badrobotics/Raptor2000/(threads)

Thread 1 (2019-05-30):

USB OTG Support

dkitzman, 2019-05-30:
The current USB setup only hooks up the data lines. I believe that using OTG requires us to do more stuff, but could allow us to be more flexible in the future with master/slave behavior.

dkitzman, 2019-06-01:
4.3.3 USB OTG
TM4C129x devices that support USB OTG mode include the signals for USB Device mode, signals for
USB Host mode and an additional signal USB0ID located on pin PB0. This USB ID signal is the 5th pin
found on a USB micro-AB connector. If a micro-A cable end is plugged into this connector, the ID pin on
the cable is tied to ground causing the TM4C129x device to operate as a USB host. If a micro-B cable end
is plugged into the USB connector, the ID pin is left floating. In this case, the TM4C129x device's internal
pull-up on the USB0ID signal causes the controller to operate in device mode.
In order to limit damage from ESD events, a 100Ω resistor should be placed in series between the ID pin
on the USB connector and USB0ID(PB0) on the microcontroller.
To support full USB OTG negotiation using the SRP and HNP protocols, VBUS from the USB connector
must be directly connected to USB0VBUS(PB1) of the microcontroller without a series resistor in between.
In this case, USB0VBUS should be connected to an ESD suppressor such as a TVS diode, or ESD
resistant VBUS switch.

dkitzman, 2019-06-06:
Resolved in PR #9

Closed 2019-06-06.

Thread 2 (2019-06-01):

Real-time Clock Support

dkitzman, 2019-06-01:
We'd like to be able to use the RTC peripheral. I think all this will take is a battery, but I'm not sure.

dkitzman, 2019-06-05:
http://www.ti.com/lit/an/spma056/spma056.pdf

TI has info about this on page 23. Looks like I need a couple passive components, and also a 32kHz oscillator to run the hibernation module. Not sure if powering the hibernation module is required for the RTC, or if it's just the other way around? Either way, I likely want a config resistor that lets me short VBatt to VDD in the case we don't install a battery.

Closed 2019-06-29.

Thread 3 (2019-06-01):

External EPI RAM

dkitzman, 2019-06-01:
We need more memory than the TM4C129 can give us. We can go up to 64KB, and I think we should.

dkitzman, 2019-06-01:
The schematic for this is ready for peer review.

dkitzman, 2019-06-29:
Resolved by #12

Closed 2019-06-29.

Thread 4 (2019-06-01):

MicroSD Reader

dkitzman, 2019-06-01:
We need some NVM on this thing to store application binaries and various file system stuff. I think the easiest form for this to take is a microsd card.

dkitzman, 2019-06-01:
This circuit is ready for peer review.

dkitzman, 2019-06-19:
Remember to pull up the CS

dkitzman, 2019-06-22:
Decided to remove in favor of NAND Flash.
See issue #11

Closed 2019-06-22.

Thread 5 (2019-06-01):

Main Connector Pinout

dkitzman, 2019-06-01:
My current plan is to use a Samtec ET60T as the primary connector on this card. Which configuration of this we go with is up to more discussion.

Signals this board needs:
- Ethernet * 4
- USB * 4
- Board Sense
- JTAG * 5
- Enable
- Inhibit
- Sysreset

That's 17 of our 24 pins. Comment on this issue if you think of anything else.

dkitzman, 2019-06-29:
Resolved by #12

Closed 2019-06-29.

Thread 7 (2019-06-01):

TM4C129x Supporting Circuitry

dkitzman, 2019-06-01:
This is our main cpu on this board, and it requires some supporting components to function properly. Read the datasheet!

dkitzman, 2019-06-29:
Resolved by #12

Closed 2019-06-29.

Thread 8 (2019-06-01):

Misc LEDs and Status Indicators

dkitzman, 2019-06-01:
The current design doesn't have any LEDs apart from a power LED. We want Ethernet leds, and probably some generic, cpu controlled ones as well.

dkitzman, 2019-06-29:
Resolved by #12

Closed 2019-06-29.
