badrobotics/Raptor2000/doc/sch/Raptor2000.pdf

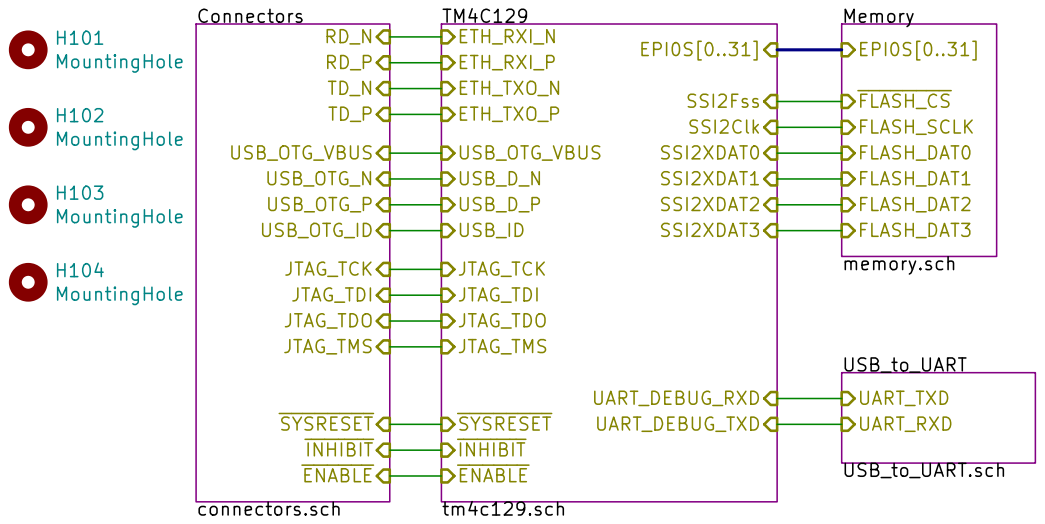
[picture p1: page 1]

File: Raptor2000.sch Sheet: / BAD Robotics

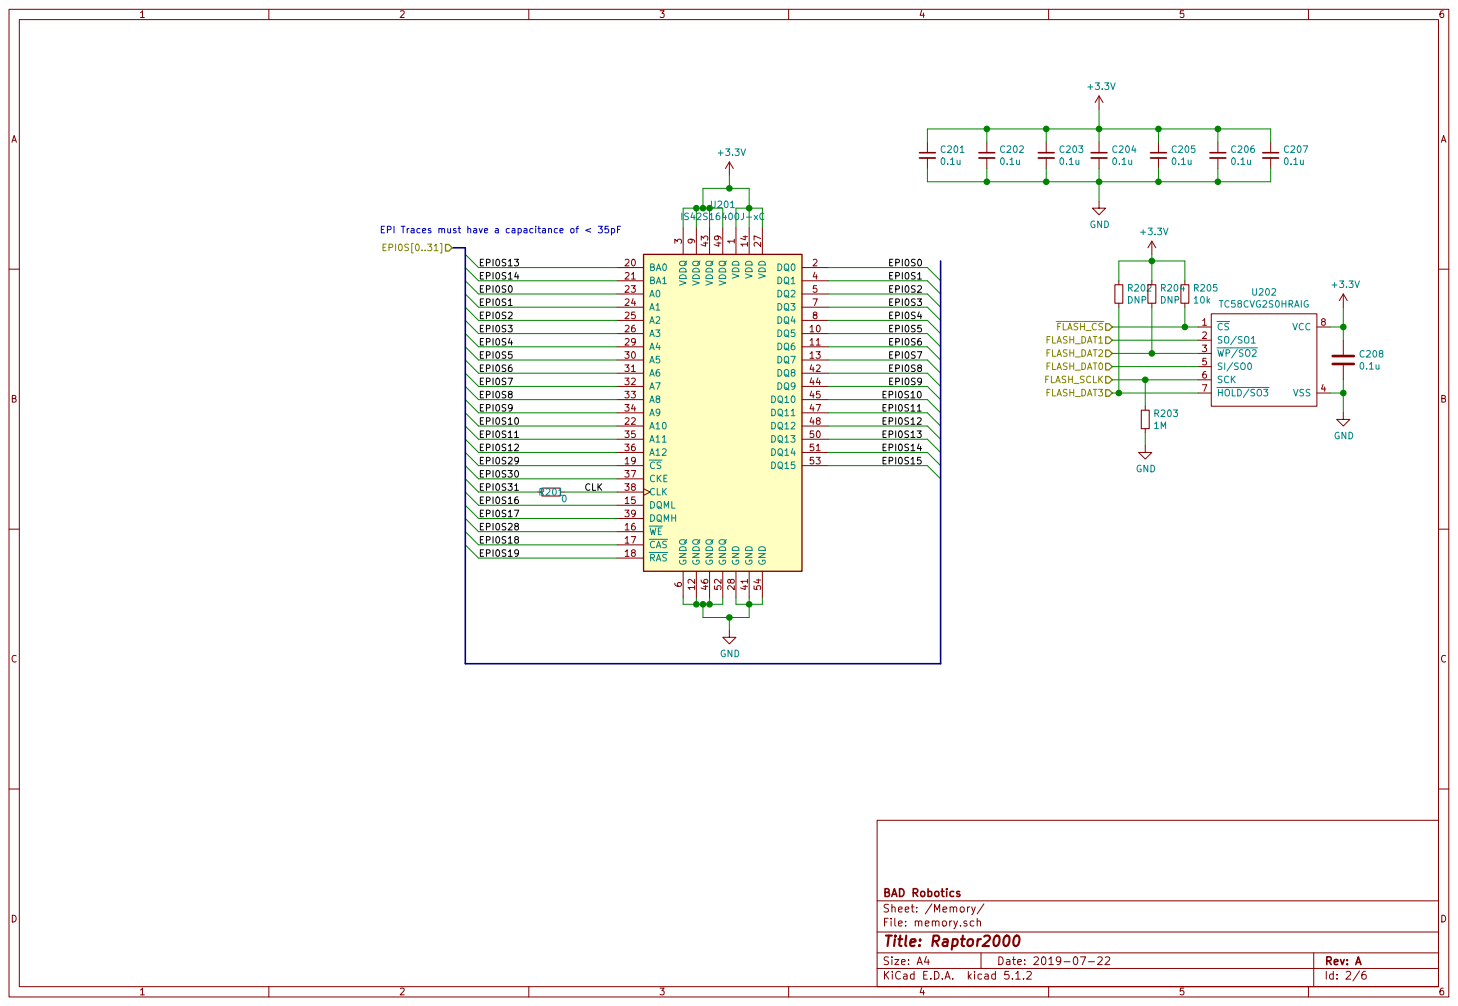
[picture p2: page 2]

EPI Traces must have a capacitance of < 35pF

1 DQ5 10 DQ6 11 GNDQ 12 DQ7 13 VDD 14 DQML 15 WE 16 CAS 17 RAS 18 CS 19 DQ0 2 BA0 20 BA1 21 A10 22 A0 23 A1 24 A2 25 A3 26 VDD 27 GND 28 A4 29 VDDQ

3 A5 30 A6 31 A7 32 A8 33 A9 34 A11 35 A12 36 CKE 37 CLK 38 DQMH 39 DQ1 4 GND 41 DQ8 42 VDDQ 43 DQ9 44 DQ10 45 GNDQ 46 DQ11 47 DQ12 48 VDDQ 49 DQ2 5 DQ13 50 DQ14 51 GNDQ 52 DQ15 53 GND 54 GNDQ

Sheet: /Memory/ BAD Robotics R201

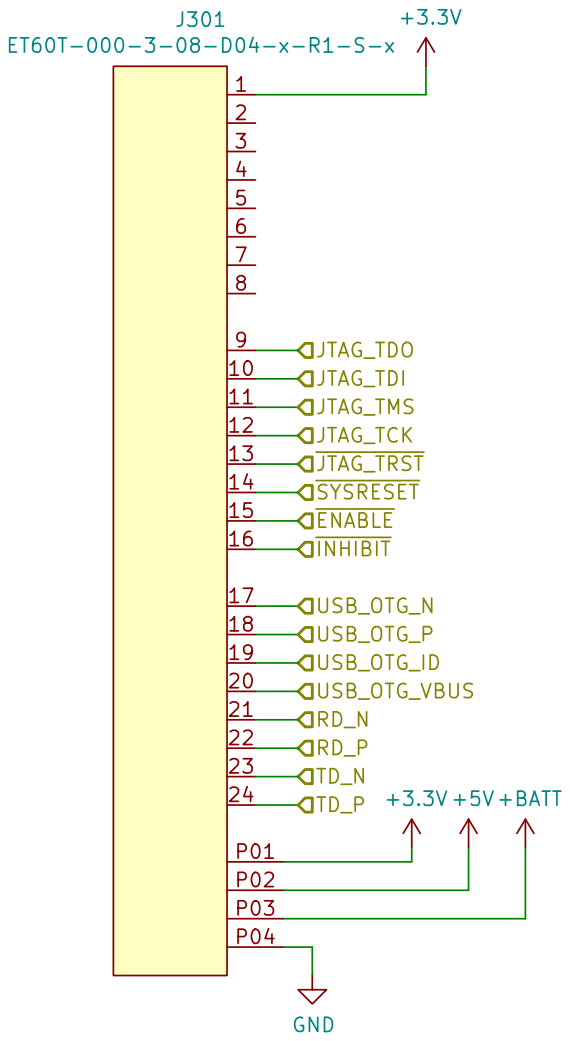
[picture p3: page 3]

USB_OTG_VBUS USB_OTG_N
USB_OTG_P
File: connectors.sch Sheet: /Connectors/ BAD Robotics USB_OTG_ID

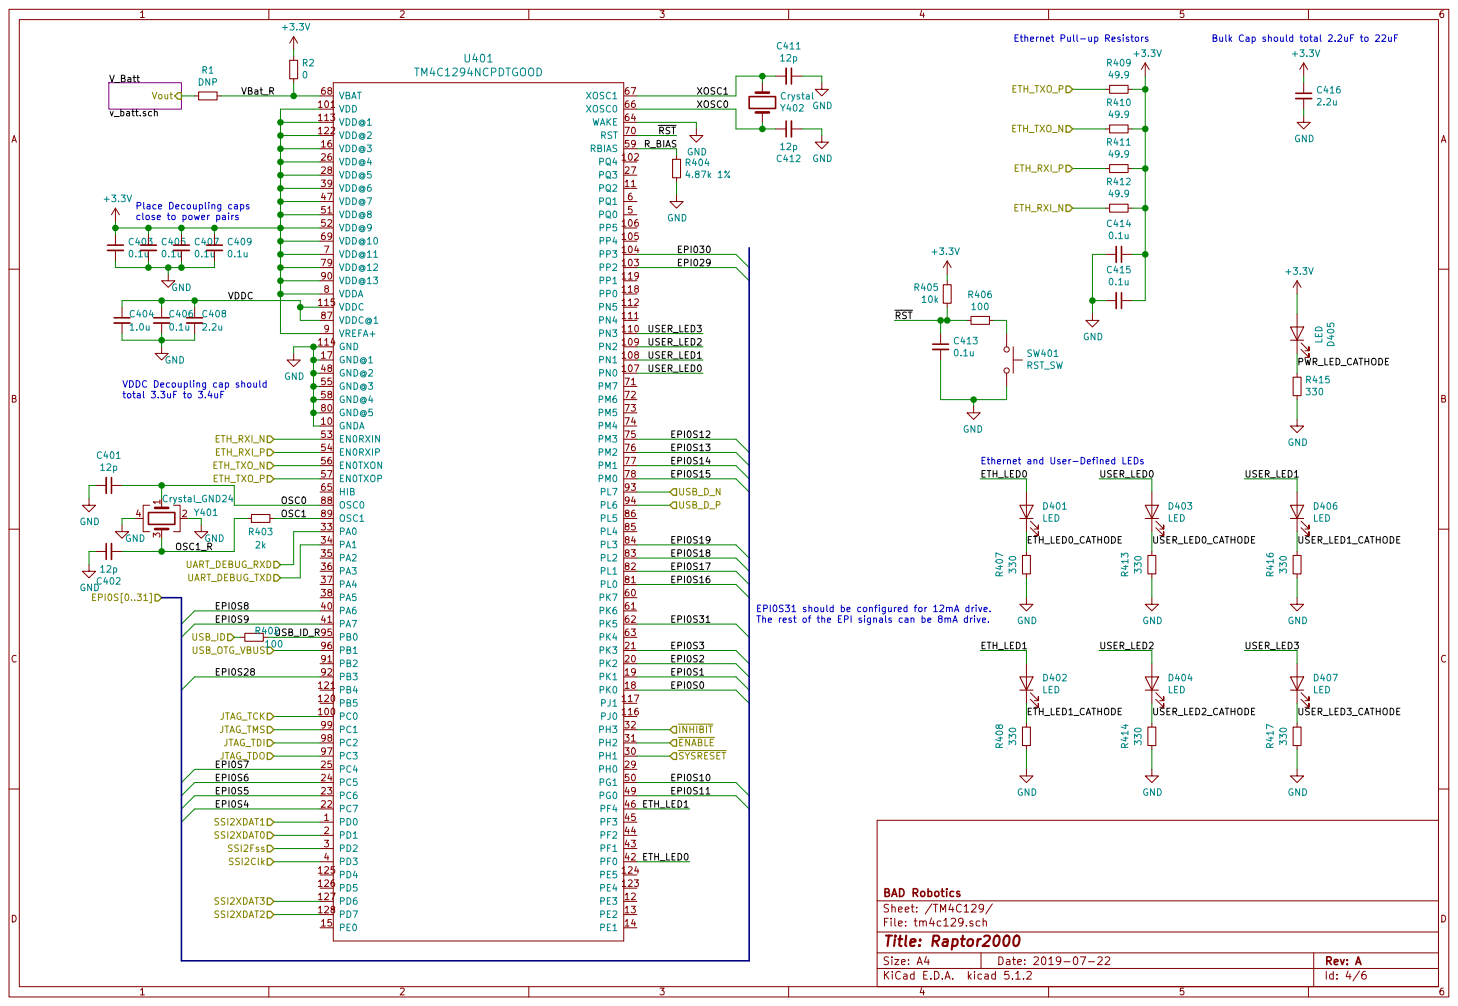
[picture p4: page 4]

File: tm4c129.sch Sheet: /TM4C129/ BAD Robotics OSC0 OSC1 C404

VDDC Decoupling cap should

The rest of the EPI signals can be 8mA drive.

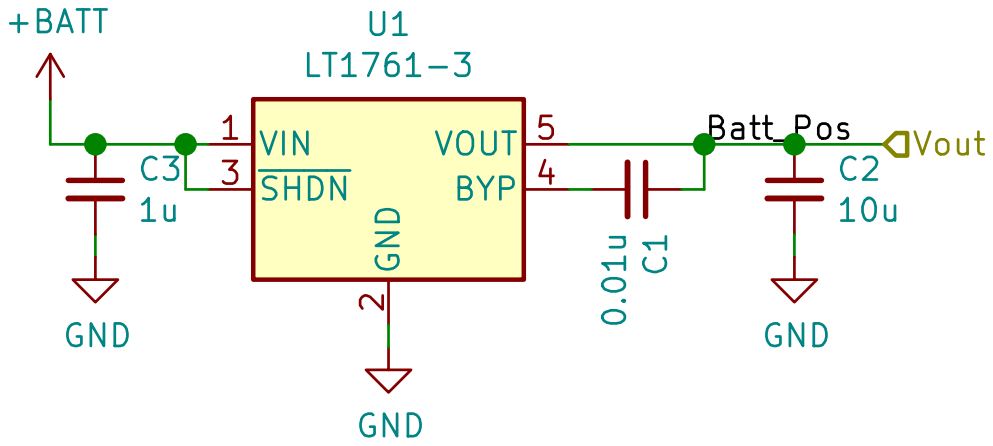
[picture p5: page 5]

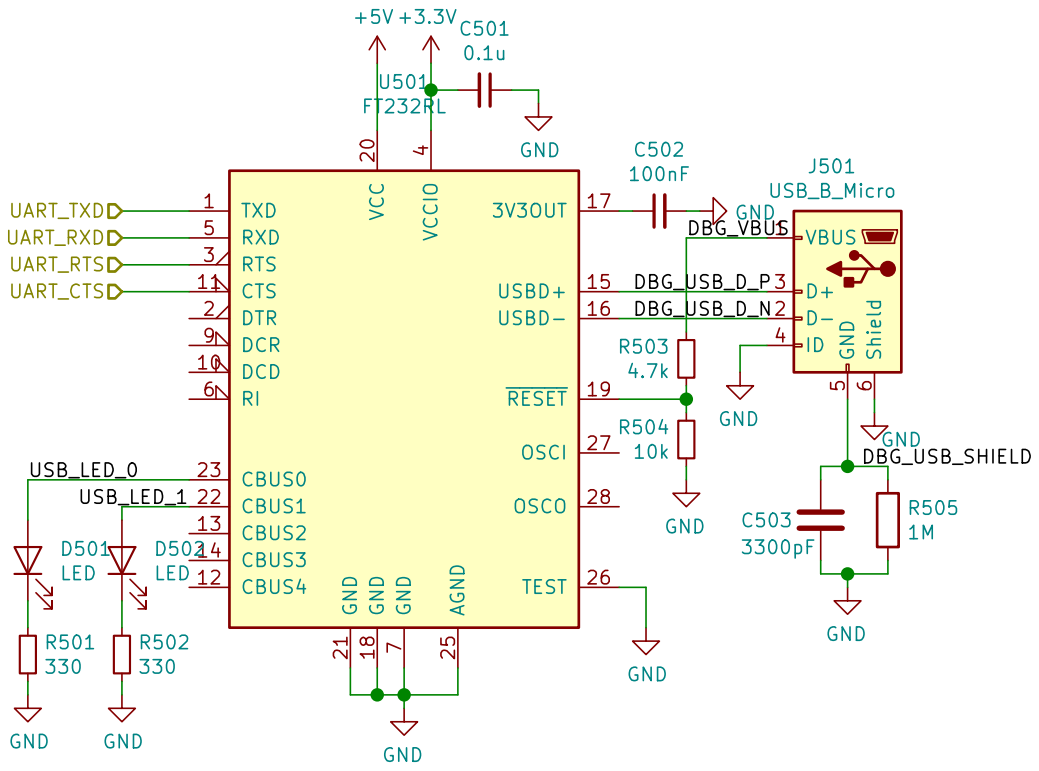
[picture p6: page 6]
