badrobotics/Raptor2000/doc/pcb/Raptor2000-B_Cu.pdf

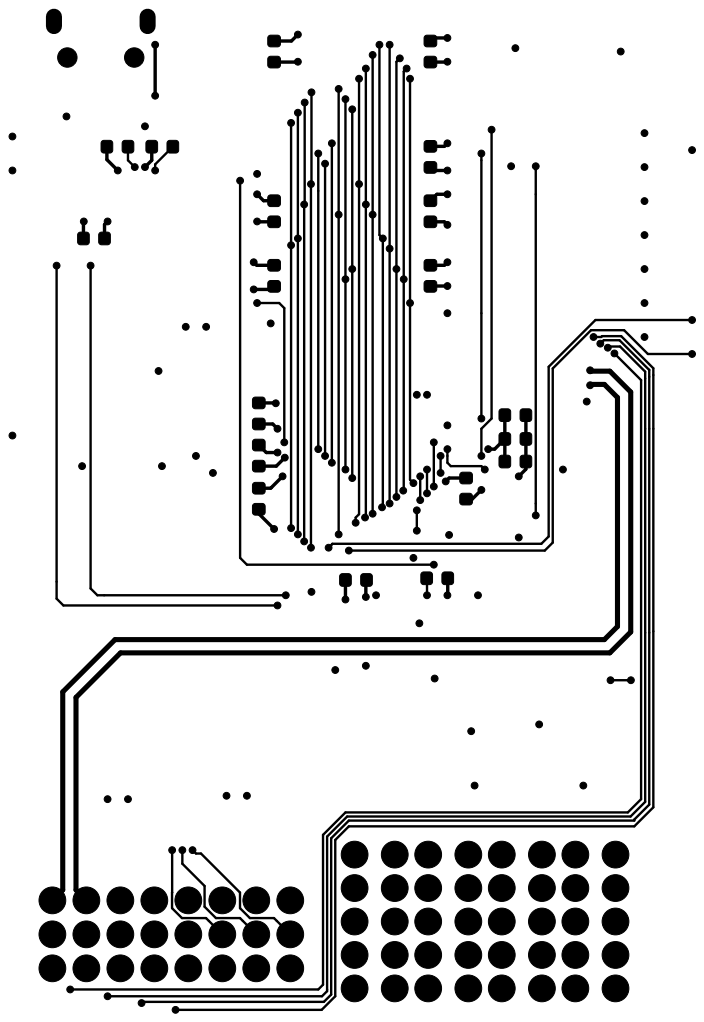
[picture p7: page 1]
