badrobotics/Raptor2000/doc/pcb/Raptor2000-B_Mask.pdf

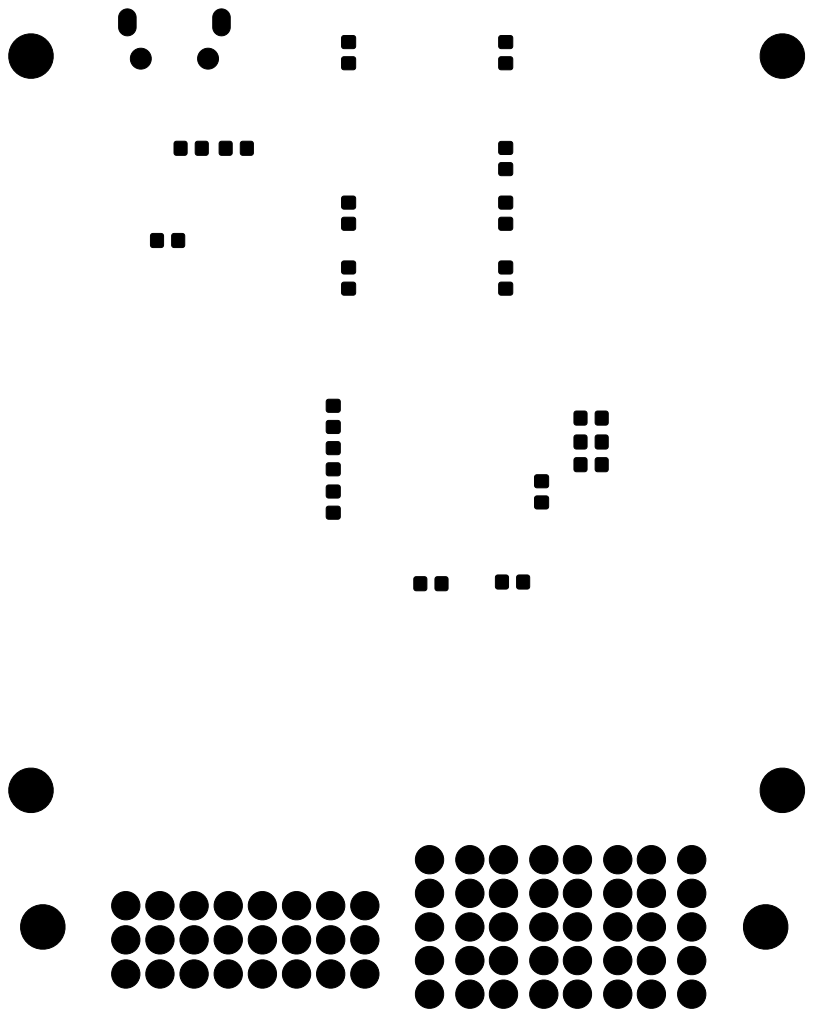
[picture p8: page 1]
