badrobotics/Raptor2000/doc/pcb/Raptor2000-B_Paste.pdf

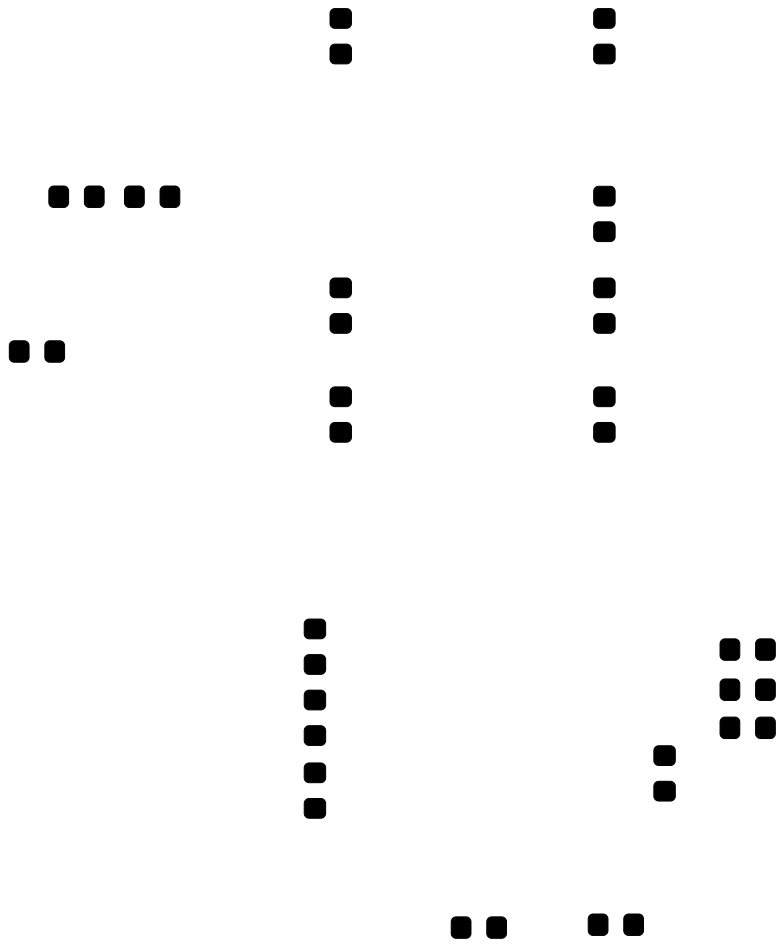
[picture p9: page 1]
