badrobotics/Raptor2000/doc/pcb/Raptor2000-B_SilkS.pdf

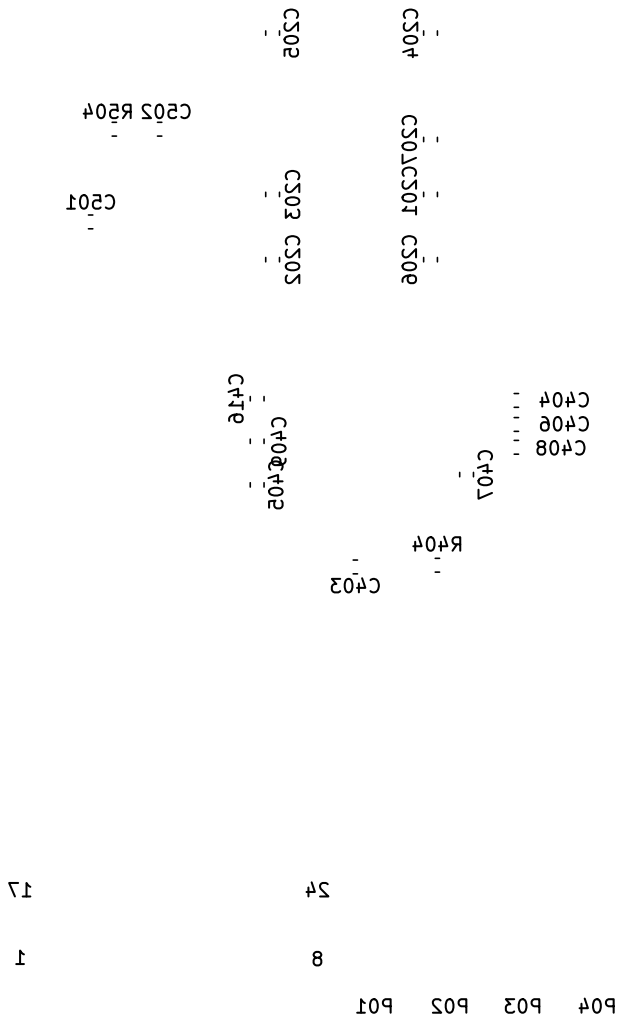
[picture p10: page 1]
