badrobotics/Raptor2000/doc/pcb/Raptor2000-F_Cu.pdf

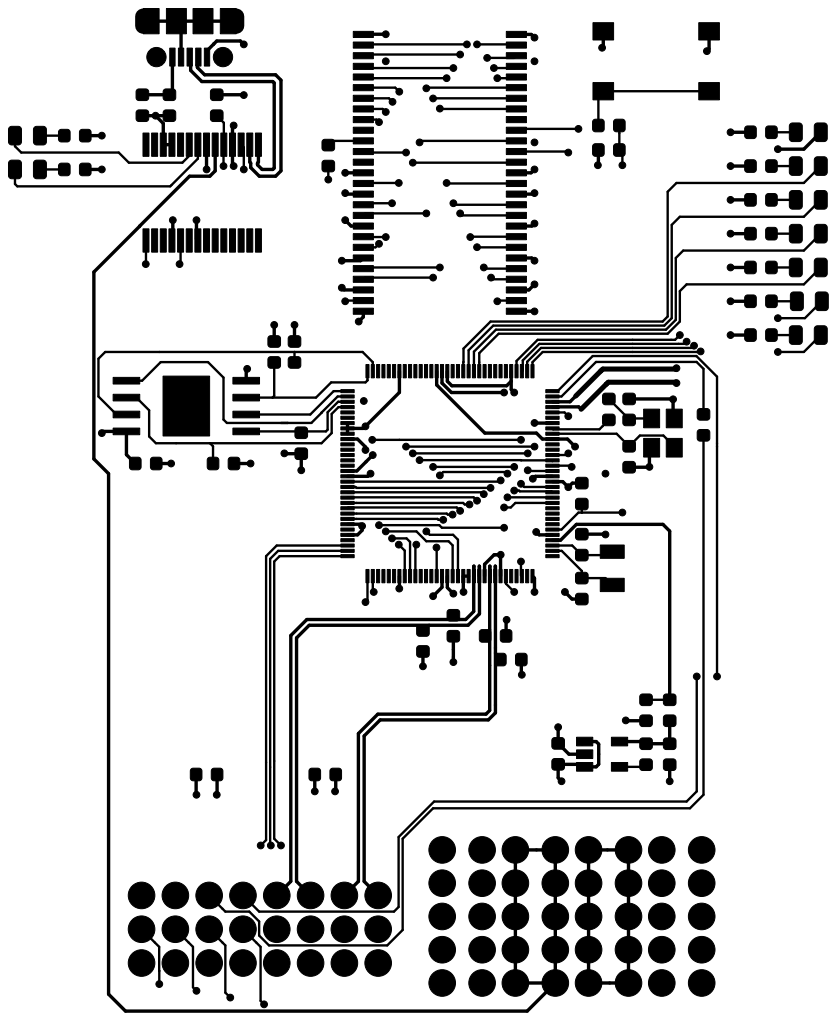
[picture p11: page 1]
