badrobotics/Raptor2000/doc/pcb/Raptor2000-F_Mask.pdf

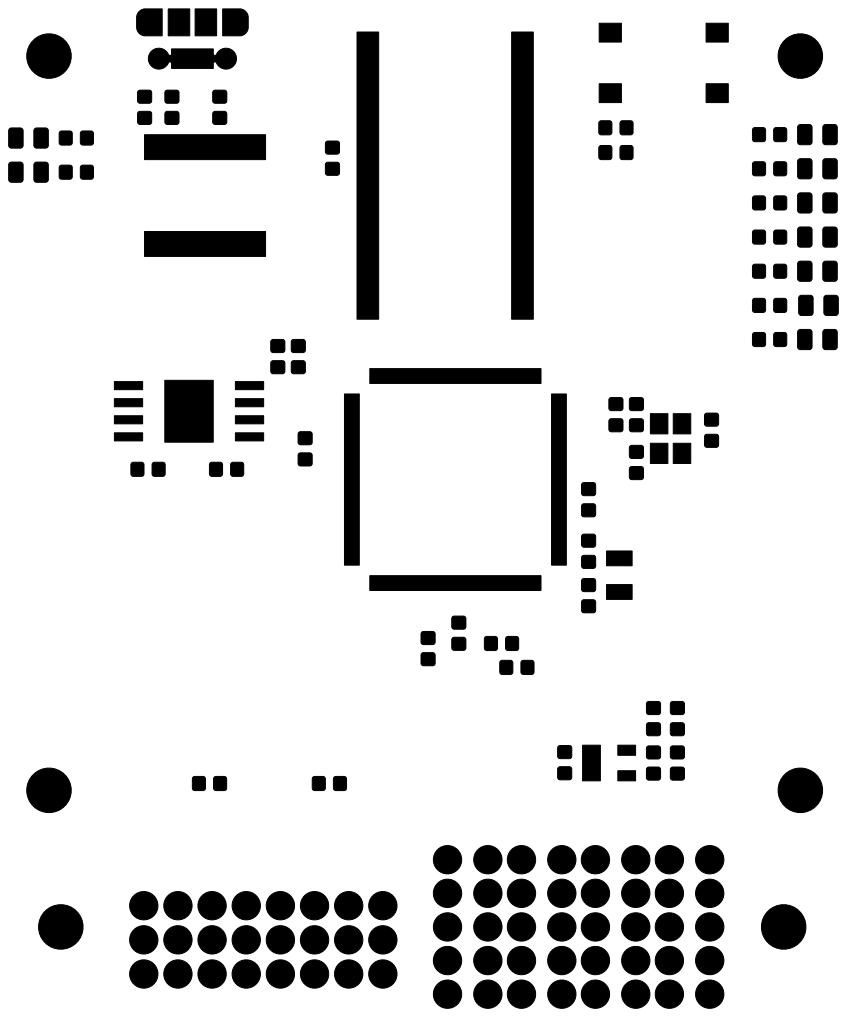
[picture p12: page 1]
