badrobotics/Raptor2000/doc/pcb/Raptor2000-F_Paste.pdf

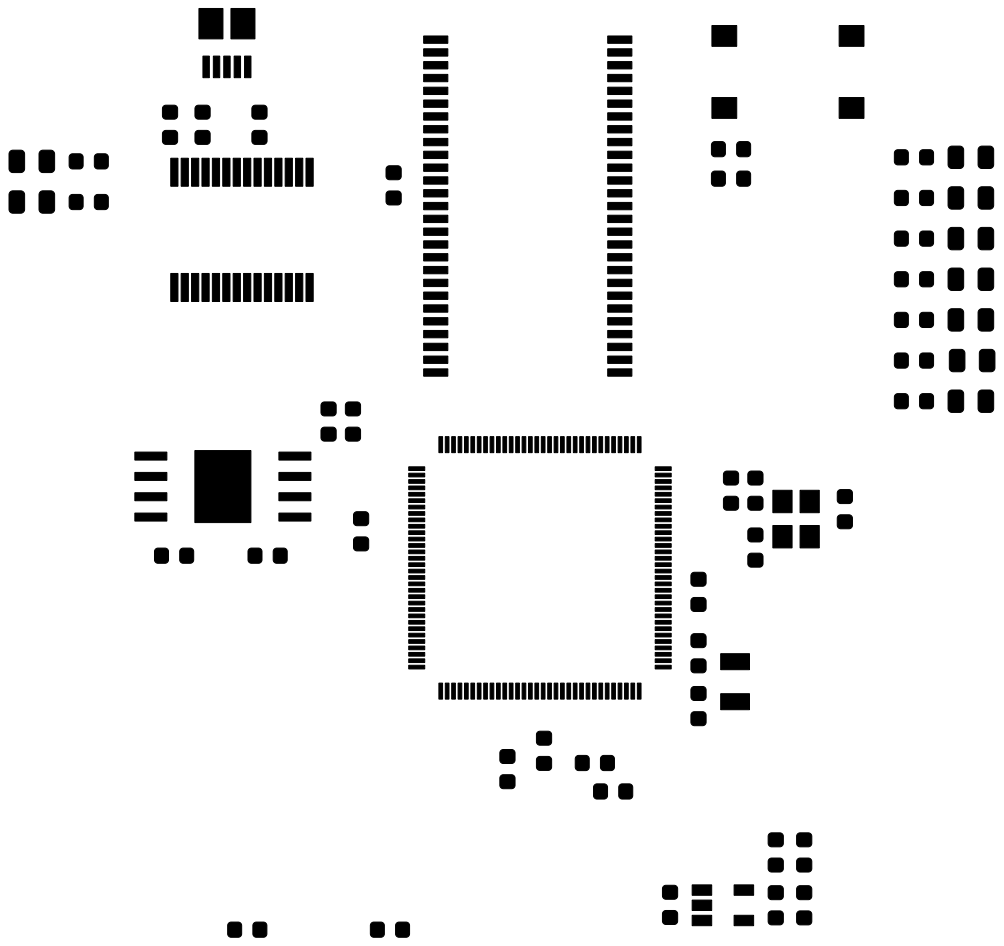
[picture p13: page 1]
