badrobotics/Raptor2000/doc/pcb/Raptor2000-F_SilkS.pdf

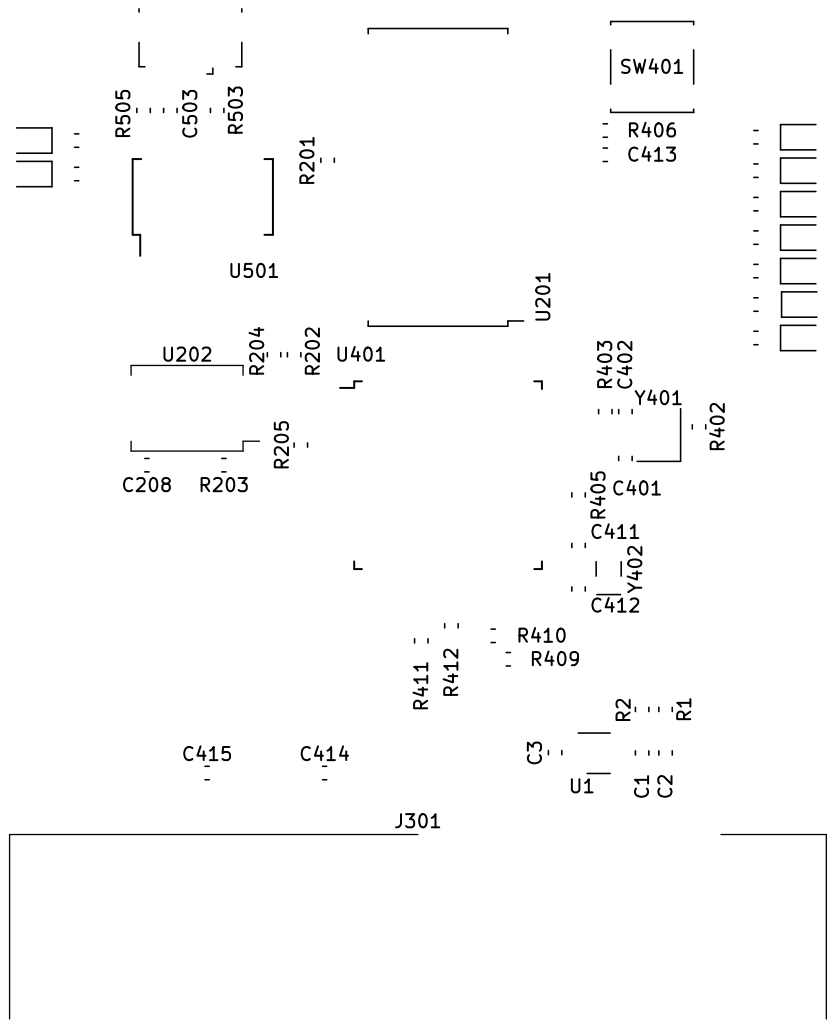
[picture p14: page 1]
