badrobotics/Raptor2000/doc/pcb/Raptor2000-In1_Cu.pdf

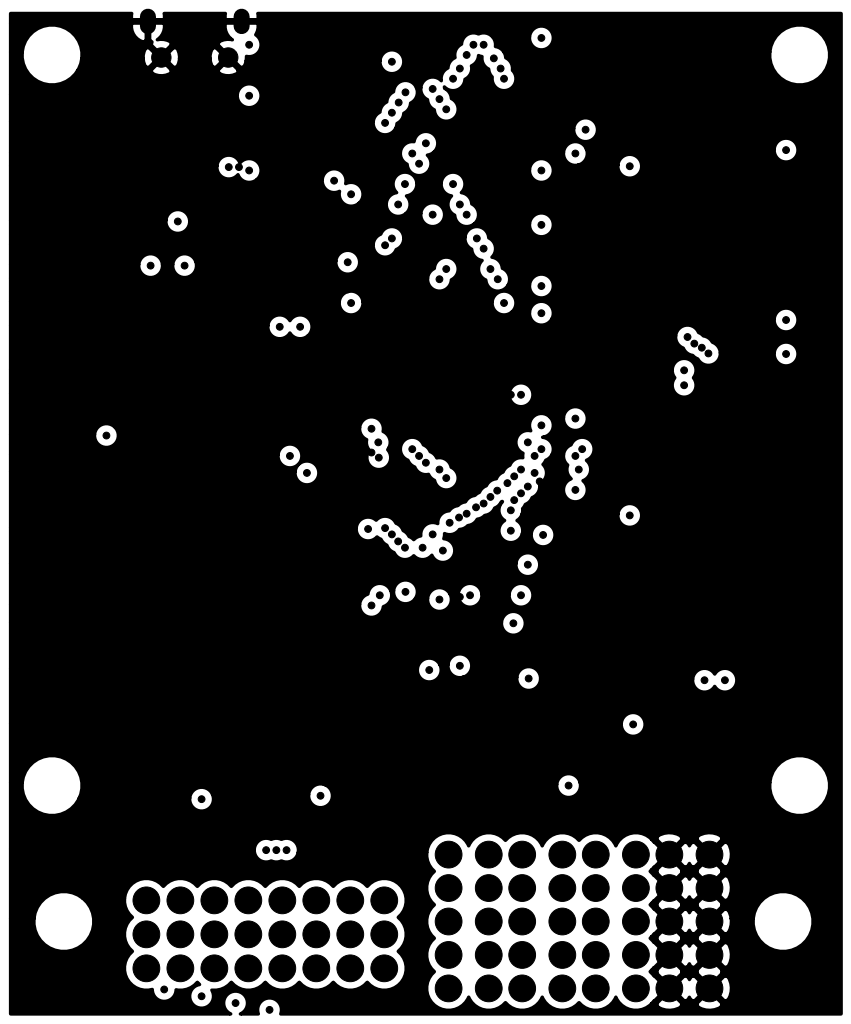
[picture p15: page 1]
