badrobotics/Raptor2000/doc/pcb/Raptor2000-In2_Cu.pdf

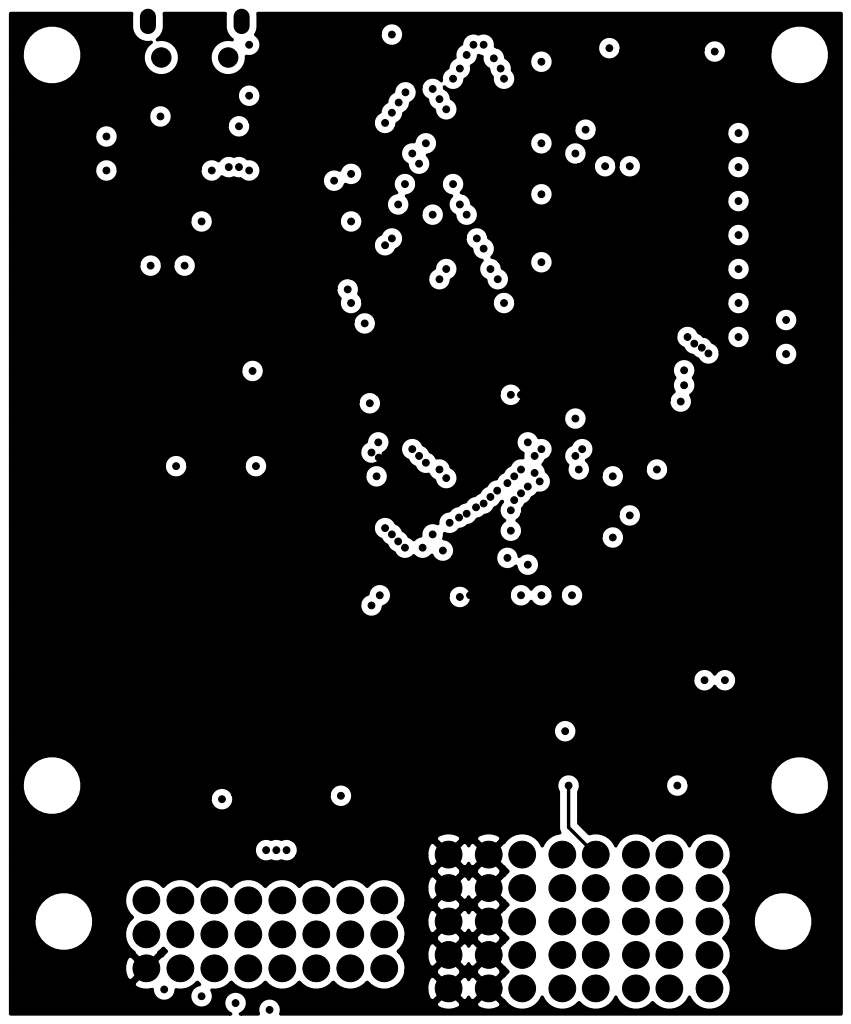
[picture p16: page 1]
