badrobotics/Raptor2000/doc/vbatt_lt1761.asc

C1: cap; 1µ
C2: cap; 0.01µ
C3: cap; 10µ
C4: cap; 1µ
R1: res; 51
U1: LT1761-3
V1: voltage; 12
Named nets: 0
.tran .05 startup
