badrobotics/Raptor2000/Raptor2000.kicad_pcb

## KiCad design Raptor2000.kicad_pcb (2019-07-23)

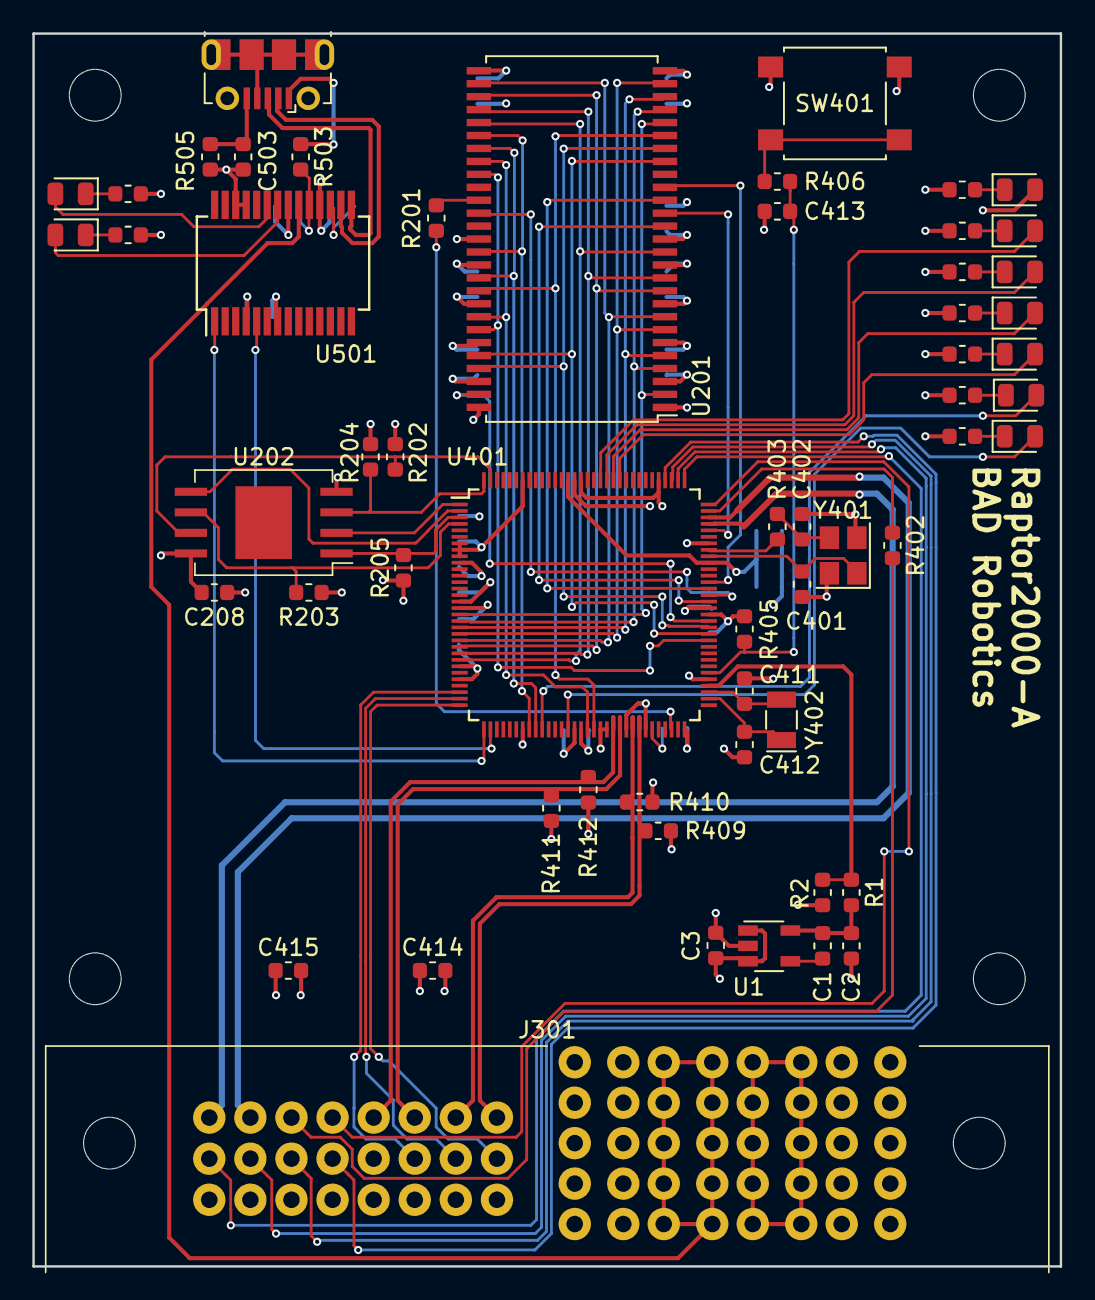
[picture p17: board Raptor2000.kicad_pcb from above]

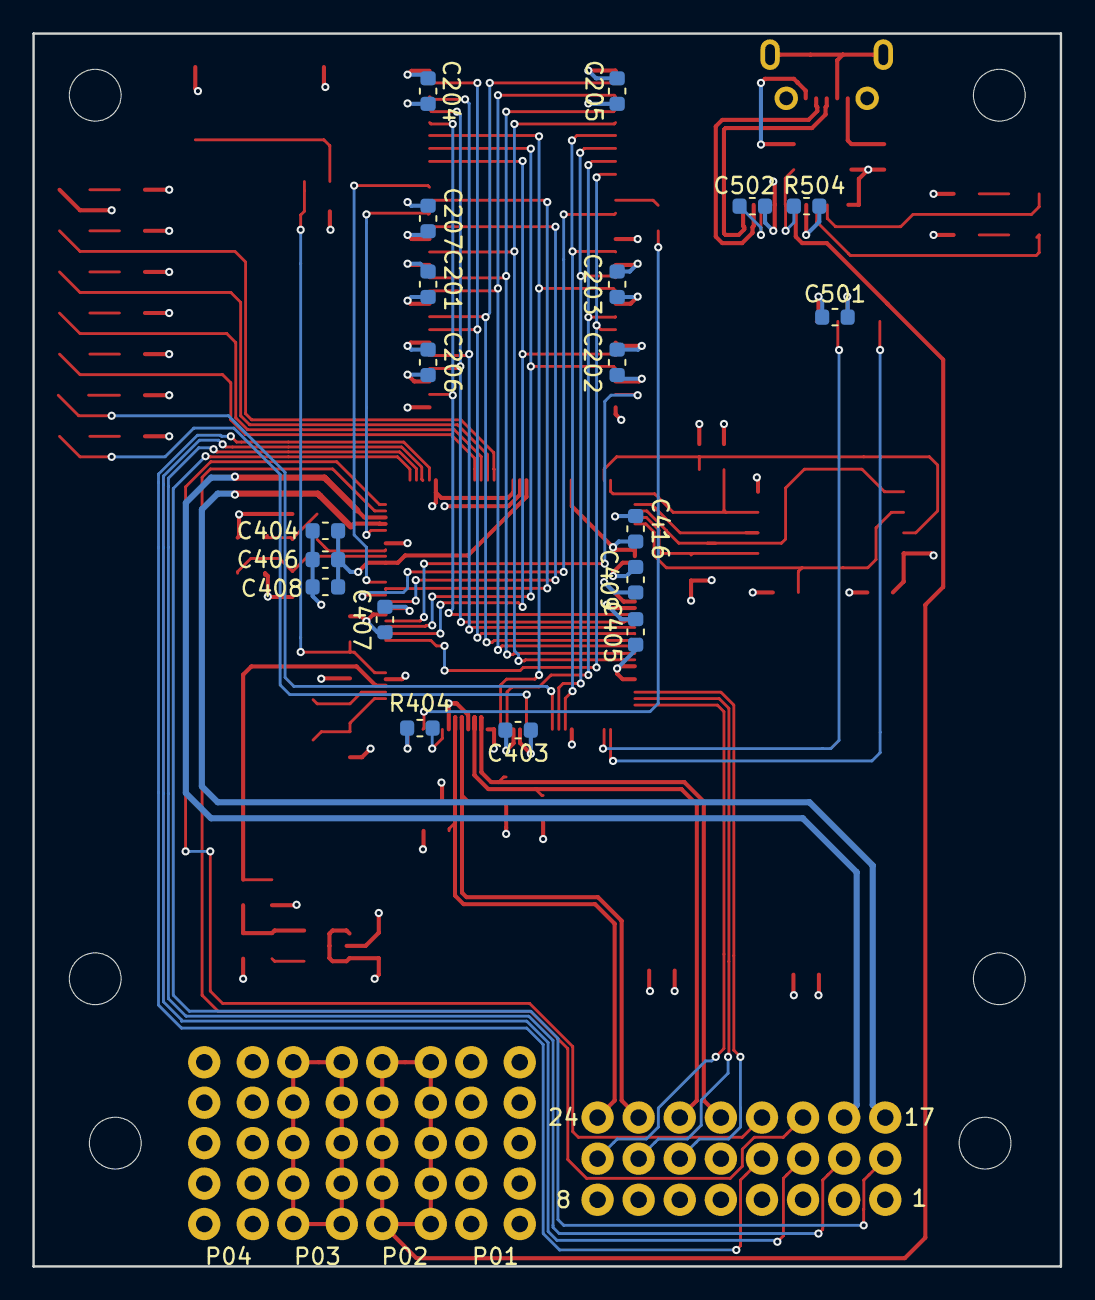
[picture p18: board Raptor2000.kicad_pcb from below]

Board: 4 copper layers, 63.5 x 76.2 mm, 80 parts (19 on the bottom side), 86 nets.

Parts:
C1: 0.01u; C_0603_1608Metric
C2: 10u; C_0603_1608Metric
C3: 1u; C_0603_1608Metric
C201, C202, C203, C204, C205, C206, C207, C208, C403, C405, C406, C407, C409, C413, C414, C415, C501: 0.1u; C_0603_1608Metric
C401, C402, C411, C412: 12p; C_0603_1608Metric
C404: 1.0u; C_0603_1608Metric
C408, C416: 2.2u; C_0603_1608Metric
C502: 100nF; C_0603_1608Metric
C503: 3300pF; C_0603_1608Metric
D401, D402, D403, D404, D405, D406, D407, D501, D502: LED; LED_0805_2012Metric
H101, H102, H103, H104: MountingHole; MountingHole_3.2mm_M3
J301: ET60T-000-3-08-D04-x-R1-S-x; Conn_Samtec_ET60T-000-3-08-D-4-x-R1-S-x
J501: USB_B_Micro; USB_Micro-B_Molex-105017-0001
R1, R202, R204: DNP; R_0603_1608Metric
R2, R201: 0; R_0603_1608Metric
R203, R505: 1M; R_0603_1608Metric
R205, R405, R504: 10k; R_0603_1608Metric
R402, R406: 100; R_0603_1608Metric
R403: 2k; R_0603_1608Metric
R404: 4.87k 1%; R_0603_1608Metric
R407, R408, R413, R414, R415, R416, R417, R501, R502: 330; R_0603_1608Metric
R409, R410, R411, R412: 49.9; R_0603_1608Metric
R503: 4.7k; R_0603_1608Metric
SW401: RST_SW; SW_SPST_B3S-1000
U1: LT1761-3; TSOT-23-5
U201: IS42S16400J-xC; TSOP-II-54_22.2x10.16mm_P0.8mm
U202: TC58CVG2S0HRAIG; WSON-8-1EP_3.4x4.3mm_P1.27mm
U401: TM4C1294NCPDTGOOD; TQFP-128_14x14mm_P0.4mm
U501: FT232RL; SSOP-28_5.3x10.2mm_P0.65mm
Y401: Crystal_GND24; Crystal_SMD_3225-4Pin_3.2x2.5mm
Y402: Crystal; Crystal_SMD_MicroCrystal_CC7V-T1A-2Pin_3.2x1.5mm

Connections:
+3V3: C201.1, C202.1, C203.1, C204.1, C205.1, C206.1, C207.1, C208.1, C403.1, C405.1, C407.1, C409.1, C414.1, C415.1, C416.1, C501.2, D405.2, J301.1, J301.P01, R2.2, R202.1, R204.1, R205.1, R405.2, R409.1, R410.1, R411.1, R412.1, U201.1, U201.3, U201.9, U201.14, U201.27, U201.43, U201.49, U202.8, U401.7, U401.8, U401.9, U401.16, U401.26, U401.28, U401.39, U401.47, U401.51, U401.52, U401.69, U401.79, U401.90, U401.101, U401.113, U401.122, U501.4
+5V: J301.P02, U501.20
+BATT: C3.1, J301.P03, U1.1, U1.3
/Connectors/JTAG_TCK: J301.12, U401.100
/Connectors/JTAG_TDI: J301.10, U401.98
/Connectors/JTAG_TDO: J301.9, U401.97
/Connectors/JTAG_TMS: J301.11, U401.99
/Connectors/USB_OTG_VBUS: J301.20, U401.96
/Connectors/~ENABLE: J301.15, U401.31
/Connectors/~INHIBIT: J301.16, U401.32
/Connectors/~SYSRESET: J301.14, U401.30
/Memory/CLK: R201.1, U201.38
/Memory/EPI0S0: U201.2, U201.23, U401.18
/Memory/EPI0S1: U201.4, U201.24, U401.19
/Memory/EPI0S2: U201.5, U201.25, U401.20
/Memory/EPI0S3: U201.7, U201.26, U401.21
/Memory/EPI0S4: U201.8, U201.29, U401.22
/Memory/EPI0S5: U201.10, U201.30, U401.23
/Memory/EPI0S6: U201.11, U201.31, U401.24
/Memory/EPI0S7: U201.13, U201.32, U401.25
/Memory/EPI0S8: U201.33, U201.42, U401.40
/Memory/EPI0S9: U201.34, U201.44, U401.41
/Memory/EPI0S10: U201.22, U201.45, U401.50
/Memory/EPI0S11: U201.35, U201.47, U401.49
/Memory/EPI0S12: U201.36, U201.48, U401.75
/Memory/EPI0S13: U201.20, U201.50, U401.76
/Memory/EPI0S14: U201.21, U201.51, U401.77
/Memory/EPI0S15: U201.53, U401.78
/Memory/EPI0S16: U201.15, U401.81
/Memory/EPI0S17: U201.39, U401.82
/Memory/EPI0S18: U201.17, U401.83
/Memory/EPI0S19: U201.18, U401.84
/Memory/EPI0S28: U201.16, U401.92
/Memory/EPI0S31: R201.2, U401.62
/Memory/FLASH_DAT0: U202.5, U401.2
/Memory/FLASH_DAT1: U202.2, U401.1
/Memory/FLASH_DAT2: R204.2, U202.3, U401.128
/Memory/FLASH_DAT3: R202.2, U202.7, U401.127
/Memory/FLASH_SCLK: R203.1, U202.6, U401.4
/TM4C129/ETH_LED0: D401.2, U401.42
/TM4C129/ETH_LED0_CATHODE: D401.1, R407.2
/TM4C129/ETH_LED1: D402.2, U401.46
/TM4C129/ETH_LED1_CATHODE: D402.1, R408.2
/TM4C129/ETH_RXI_N: J301.21, R412.2, U401.53
/TM4C129/ETH_RXI_P: J301.22, R411.2, U401.54
/TM4C129/ETH_TXO_N: J301.23, R410.2, U401.56
/TM4C129/ETH_TXO_P: J301.24, R409.2, U401.57
/TM4C129/OSC0: C401.1, U401.88, Y401.1
/TM4C129/OSC1: R403.1, U401.89
/TM4C129/OSC1_R: C402.2, R403.2, Y401.3
/TM4C129/PWR_LED_CATHODE: D405.1, R415.2
/TM4C129/R_BIAS: R404.1, U401.59
/TM4C129/SSI2Fss: R205.2, U202.1, U401.3
/TM4C129/UART_DEBUG_RXD: U401.33, U501.1
/TM4C129/UART_DEBUG_TXD: U401.34, U501.5
/TM4C129/USB_D_N: J301.17, U401.93
/TM4C129/USB_D_P: J301.18, U401.94
/TM4C129/USB_ID: J301.19, R402.2
/TM4C129/USB_ID_R: R402.1, U401.95
/TM4C129/USER_LED0: D403.2, U401.107
/TM4C129/USER_LED0_CATHODE: D403.1, R413.2
/TM4C129/USER_LED1: D406.2, U401.108
/TM4C129/USER_LED1_CATHODE: D406.1, R416.2
/TM4C129/USER_LED2: D404.2, U401.109
/TM4C129/USER_LED2_CATHODE: D404.1, R414.2
/TM4C129/USER_LED3: D407.2, U401.110
/TM4C129/USER_LED3_CATHODE: D407.1, R417.2
/TM4C129/VBat_R: R1.1, R2.1, U401.68
/TM4C129/VDDC: C404.1, C406.1, C408.1, U401.87, U401.115
/TM4C129/V_Batt/Vout: C1.1, C2.1, R1.2, U1.5
/TM4C129/XOSC0: C412.1, U401.66, Y402.1
/TM4C129/XOSC1: C411.2, U401.67, Y402.2
/TM4C129/~RST: C413.1, R405.1, R406.1, U401.70
/USB_to_UART/DBG_USB_D_N: J501.2, U501.16
/USB_to_UART/DBG_USB_D_P: J501.3, U501.15
/USB_to_UART/DBG_USB_SHIELD: C503.1, J501.5, R505.1
/USB_to_UART/DBG_VBUS: J501.1, R503.1
/USB_to_UART/USB_LED_0: D501.2, U501.23
/USB_to_UART/USB_LED_1: D502.2, U501.22
GND: C2.2, C3.2, C201.2, C202.2, C203.2, C204.2, C205.2, C206.2, C207.2, C208.2, C401.2, C402.1, C403.2, C404.2, C405.2, C406.2, C407.2, C408.2, C409.2, C411.1, C412.2, C413.2, C414.2, C415.2, C416.2, C501.1, C502.2, C503.2, J301.P04, J501.4, J501.6, R203.2, R404.2, R407.1, R408.1, R413.1, R414.1, R415.1, R416.1, R417.1, R501.2, R502.2, R504.2, R505.2, SW401.1, U1.2, U201.6, U201.12, U201.28, U201.41, U201.46, U201.52, U201.54, U202.4, U401.10, U401.17, U401.48, U401.55, U401.58, U401.64, U401.80, U401.114, U501.7, U501.18, U501.21, U501.25, U501.26, Y401.2, Y401.4
unnamed: C1.2, U1.4
unnamed: C502.1, U501.17
unnamed: D501.1, R501.1
unnamed: D502.1, R502.1
unnamed: R406.2, SW401.2
unnamed: R503.2, R504.1, U501.19
