badrobotics/Raptor2000/(commit log)

2019-05-05 initial commit for raptor2000 sbc
    [Raptor2000.kicad_pcb, Raptor2000.sch, connectors.sch, memory.sch, tm4c129.sch]
2019-05-05 adding schematic pdf
2019-05-25 fixing some unnamed nets.
    [Raptor2000.kicad_pcb, Raptor2000.sch, connectors.sch, tm4c129.sch]
2019-06-02 Connected the board sense pin to 3.3V to work with the backplane.
    [Raptor2000.sch]
2019-06-06 Added usb id and usb vbus pins to tm4c circuit. Unconnected on main backplane connector.
    [Raptor2000.sch, connectors.sch, tm4c129.sch]
2019-06-06 Changed USB ID and VBUS resistors.
    [tm4c129.sch]
2019-06-29 initial implementation of vbatt for RTC.
    [Raptor2000.sch, connectors.sch, tm4c129.sch]
2019-06-29 added nand flash, removed sd card. finished rtc circuit. added leds
    [Raptor2000.sch, connectors.sch, memory.sch, tm4c129.sch]
2019-06-29 added component values for RAM decoupling caps
    [memory.sch]
2019-06-29 updated schematic pdf
2019-06-29 fixed misnamed EPI nets.
    [Raptor2000.sch, memory.sch, tm4c129.sch]
2019-06-29 fixed component value for decoupling cap on nand flash.
    [memory.sch]
2019-06-29 added a note about EPI signal drive strength.
    [tm4c129.sch]
2019-06-29 updated come component values.
    [Raptor2000.sch, tm4c129.sch]
2019-06-29 added reset button and pullup. Moved sysreset to a gpio pin.
    [tm4c129.sch]
2019-06-29 added a debug microusb port.
    [Raptor2000.sch, USB_to_UART.sch, connectors.sch, memory.sch, tm4c129.sch]
2019-06-29 Fixed some componenet values. Added some layout notes. added decoupling cap to usb-to-uart circuit.
    [USB_to_UART.sch, connectors.sch, memory.sch, tm4c129.sch]
2019-06-29 added part footprints. added usb-uart leds.
    [USB_to_UART.sch, memory.sch, tm4c129.sch]
2019-06-29 added rtc battery footprint
    [tm4c129.sch]
2019-07-02 regenerated netlist/annotations and refdeses. using new connector symbol.
    [Raptor2000.kicad_pcb, Raptor2000.sch, USB_to_UART.sch, connectors.sch, memory.sch, tm4c129.sch]
2019-07-23 started layout. fixing some netnames.
    [Raptor2000.kicad_pcb, USB_to_UART.sch, tm4c129.sch]
2019-07-23 replaced battery with ldo connected to external vbatt. Layout passes DRC
    [Raptor2000.kicad_pcb, tm4c129.sch]
2019-07-23 moved ldo vbatt circuit to a sheet
    [Raptor2000.kicad_pcb, Raptor2000.sch, USB_to_UART.sch, connectors.sch, memory.sch, tm4c129.sch, v_batt.sch]
2019-07-23 removed rc filter on vbatt output. Included ltspice sim to prove it's unneeded.
    [Raptor2000.kicad_pcb, tm4c129.sch, v_batt.sch]
2019-07-23 sourced all parts, except LEDs. added bom. fixed a few footprints/values.
    [Raptor2000.csv, Raptor2000.kicad_pcb, USB_to_UART.sch, tm4c129.sch]
2019-07-23 bom fix
    [Raptor2000.csv]
2019-07-23 layout and schematic cleanup.
    [Raptor2000.kicad_pcb, tm4c129.sch]
2019-07-23 layout cleanup, updating pdf.
    [Raptor2000.kicad_pcb]
2019-07-23 finished layout. generated gerbers.
    [Raptor2000-B_Cu.gbr, Raptor2000-B_Mask.gbr, Raptor2000-B_Paste.gbr, Raptor2000-B_SilkS.gbr, Raptor2000-Edge_Cuts.gbr, Raptor2000-F_Cu.gbr, Raptor2000-F_Mask.gbr, Raptor2000-F_Paste.gbr]
2019-07-23 added board/company name
    [Raptor2000.kicad_pcb]
